codeTom/sensor-design-project/README.md

#### Arduino shield with an optical pulse sensor and amplifier for LM35 temperature sensor

Designed by

Filip Ayazi, Stephen De Bank, Hayley Gilbert
