codeTom/sensor-design-project/fingerholder/README.md

A simple finger-cradle with holes for 5mm LED and photodiode
