codeTom/sensor-design-project/laser_cut_case/README.md

##Case for the arduino and shield based on on OpenCase
Use openscad to build the case. The pre-built dxf is for 3mm material.

For more on OpenCase see https://github.com/joeynovak/open-arduino-case
