codeTom/sensor-design-project/fingerholder/fingertube.stl

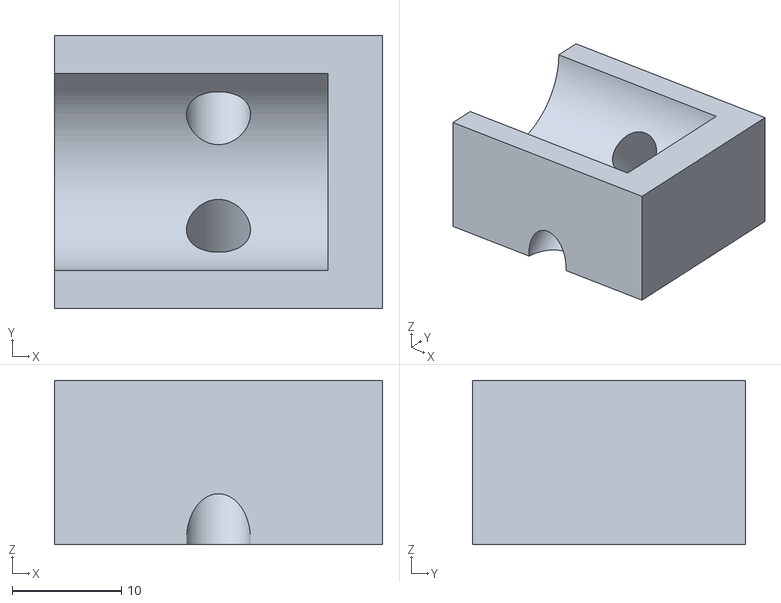
[picture p1: CAD file, 2021-12-16]
fingerholder/fingertube.stl
30.0 x 25.0 x 15.0
