codeTom/sensor-design-project/laser_cut_case/open-case.dxf

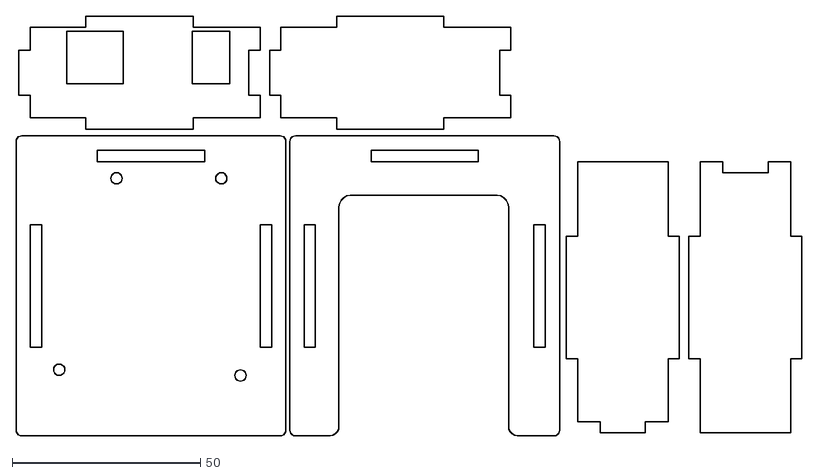
[picture p2: CAD file, 2021-12-16]
laser_cut_case/open-case.dxf
208.6 x 111.4
