codeTom/sensor-design-project/shield_schematics.pdf

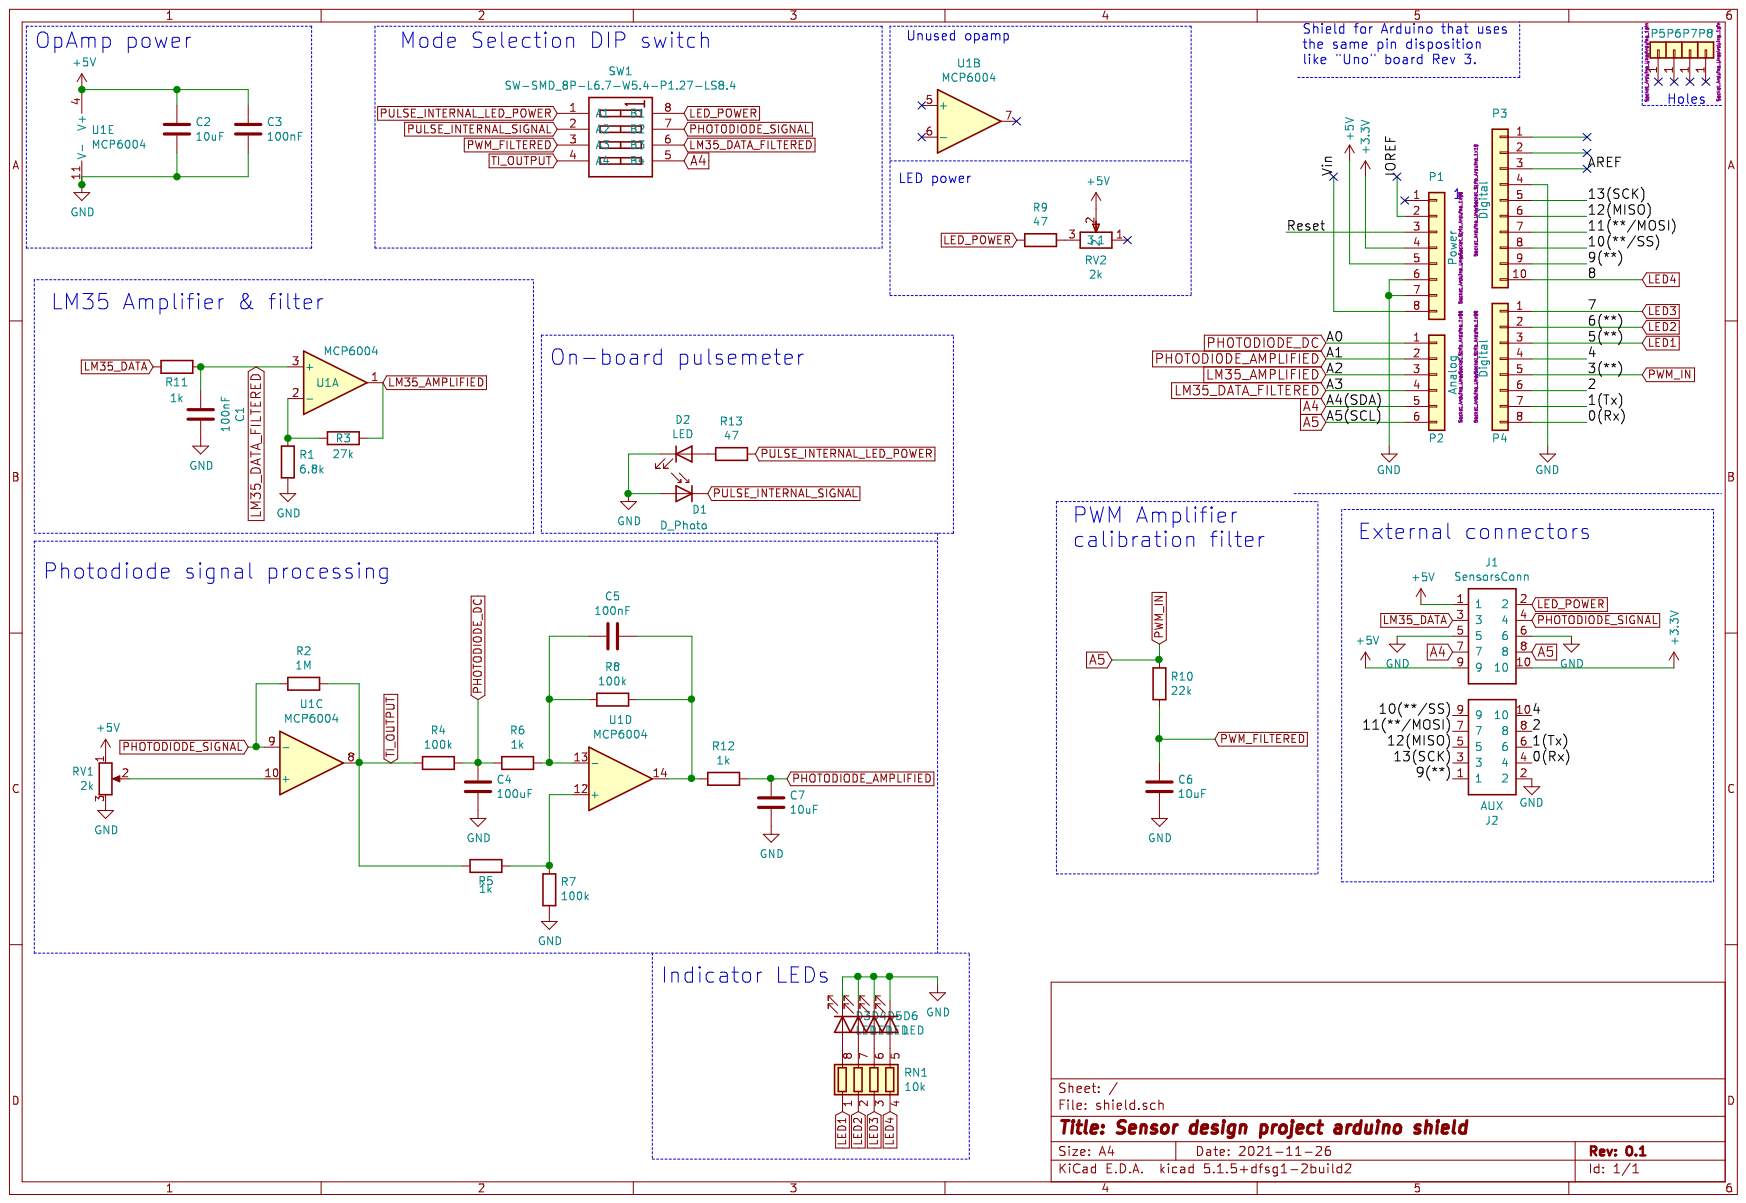
[picture p3: page 1]
