codeTom/sensor-design-project/shield/shield.kicad_pcb

## KiCad design shield/shield.kicad_pcb (2021-12-16)

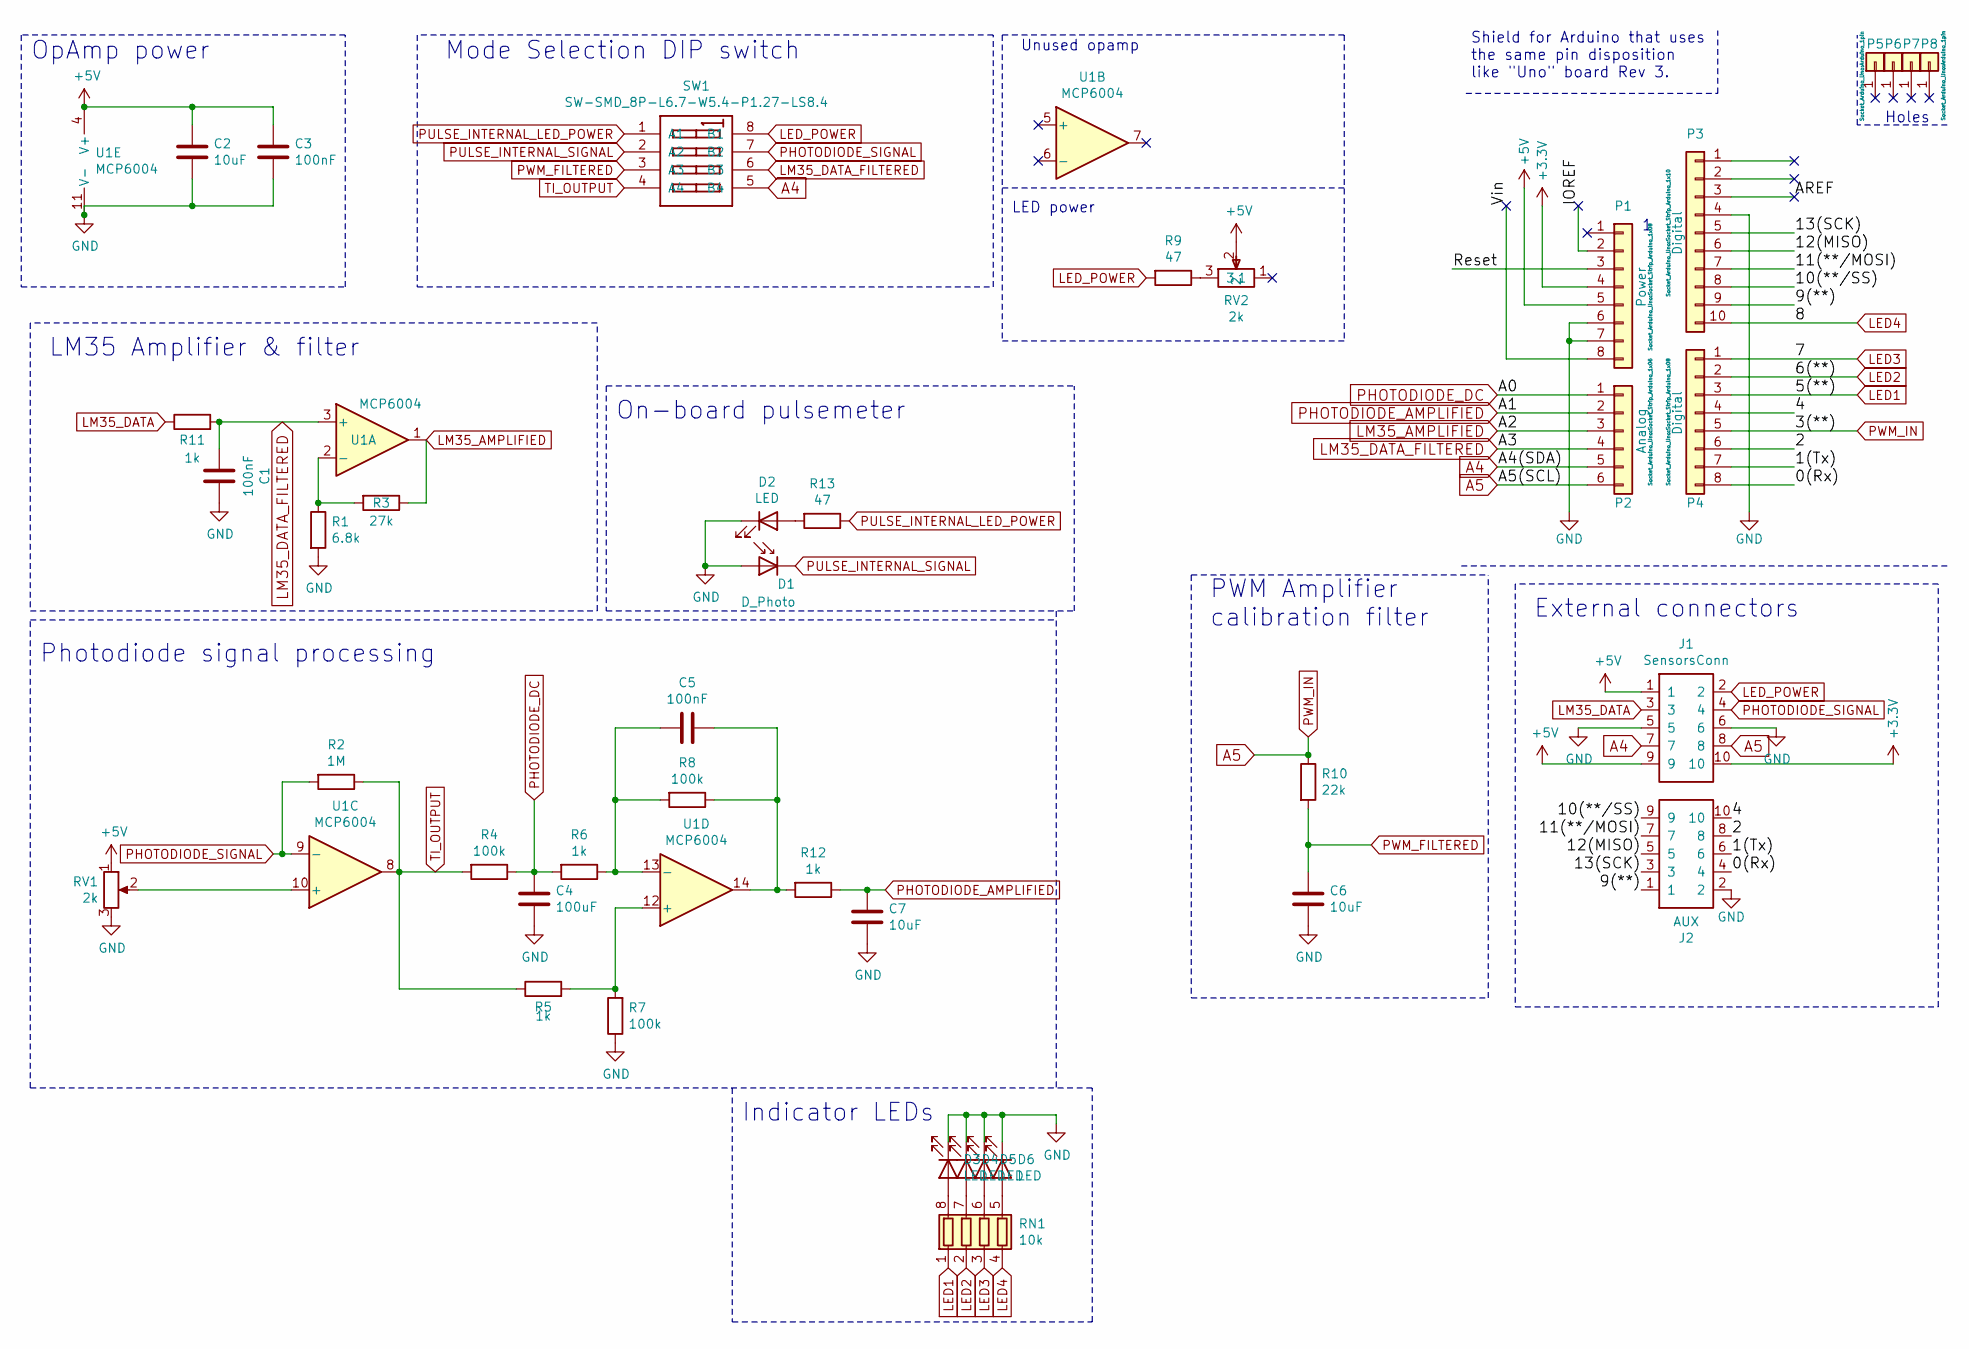
[picture p4: schematic shield.sch, Sensor design project arduino shield]

Parts:
C1, C3, C5: 100nF; C_0402_1005Metric; LCSC C1525
C2, C6, C7: 10uF; C_0402_1005Metric; LCSC C15525
C4: 100uF; C_1206_3216Metric; LCSC C15008
D1: D_Photo; LED_1206_3216Metric; LCSC C16746
D2, D3: LED; LED_0805_2012Metric; LCSC C84256
D4: LED; LED_0805_2012Metric; LCSC C2297
D5: LED; LED_0603_1608Metric; LCSC C72041
D6: LED; LED_0805_2012Metric; LCSC C2296
J1: SensorsConn; CONN-SMD_C843271; LCSC C843271
J2: AUX; CONN-SMD_C843271; LCSC C843271
P1: Power; Socket_Strip_Arduino_1x08
P2: Analog; Socket_Strip_Arduino_1x06
P3: Digital; Socket_Strip_Arduino_1x10
P4: Digital; Socket_Strip_Arduino_1x08
P5, P6, P7, P8: CONN_01X01; Arduino_1pin
R1: 6.8k; R_0603_1608Metric; LCSC C23212
R2: 1M; R_0603_1608Metric; LCSC C22935
R3: 27k; R_0603_1608Metric; LCSC C22967
R4, R7, R8: 100k; R_0603_1608Metric; LCSC C25803
R5, R6, R11, R12: 1k; R_0603_1608Metric; LCSC C21190
R9, R13: 47; R_0805_2012Metric; LCSC C17714
R10: 22k; R_0603_1608Metric; LCSC C31850
RN1: 10k; R_Array_Convex_4x0603; LCSC C29718
RV1, RV2: 2k; RES-ADJ-SMD_G43AT; LCSC C128157
SW1: SW-SMD_8P-L6.7-W5.4-P1.27-LS8.4; LCSC C40736
U1: MCP6004; TSSOP-14_4.4x5mm_P0.65mm; LCSC C50282

Connections:
+3V3: J1.10, P1.4
+5V: C2.1, C3.1, J1.1, J1.9, P1.5, RV1.1, RV2.2, U1.4 (V+)
/0(Rx): J2.4, P4.8
/1(Tx): J2.6, P4.7
/2: J2.8, P4.6
/4: J2.10, P4.4
/9(**): J2.1, P3.9
/10(**/SS): J2.9, P3.8
/11(**/MOSI): J2.7, P3.7
/12(MISO): J2.5, P3.6
/13(SCK): J2.3, P3.5
/AREF: P3.3
/IOREF: P1.2
/Reset: P1.3
/Vin: P1.8
A4: J1.7, P2.5, SW1.5 (B4)
A5: J1.8, P2.6, P4.5, R10.1
GND: C1.1, C2.2, C3.2, C4.2, C6.2, C7.2, D1.2 (A), D2.1 (K), D3.1 (K), D4.1 (K), D5.1 (K), D6.1 (K), J1.5, J1.6, J2.2, P1.6, P1.7, P3.4, R1.2, R7.1, RV1.3, U1.11 (V-)
LED1: P4.3, RN1.1 (R1.1)
LED2: P4.2, RN1.2 (R2.1)
LED3: P4.1, RN1.3 (R3.1)
LED4: P3.10, RN1.4 (R4.1)
LED_POWER: J1.2, R9.2, SW1.8 (B1)
LM35_AMPLIFIED: P2.3, R3.1, U1.1
LM35_DATA: J1.3, R11.1
LM35_DATA_FILTERED: C1.2, P2.4, R11.2, SW1.6 (B3), U1.3 (+)
unnamed: C5.1, R8.1, R12.2, U1.14
unnamed: C5.2, R6.1, R8.2, U1.13 (-)
unnamed: D2.2 (A), R13.2
unnamed: D3.2 (A), RN1.8 (R1.2)
unnamed: D4.2 (A), RN1.7 (R2.2)
unnamed: D5.2 (A), RN1.6 (R3.2)
unnamed: D6.2 (A), RN1.5 (R4.2)
unnamed: R1.1, R3.2, U1.2 (-)
unnamed: R5.2, R7.2, U1.12 (+)
unnamed: R9.1, RV2.3
unnamed: RV1.2, U1.10 (+)
PHOTODIODE_AMPLIFIED: C7.1, P2.2, R12.1
PHOTODIODE_DC: C4.1, P2.1, R4.1, R6.2
PHOTODIODE_SIGNAL: J1.4, R2.2, SW1.7 (B2), U1.9 (-)
PULSE_INTERNAL_LED_POWER: R13.1, SW1.1 (A1)
PULSE_INTERNAL_SIGNAL: D1.1 (K), SW1.2 (A2)
PWM_FILTERED: C6.1, R10.2, SW1.3 (A3)
TI_OUTPUT: R2.1, R4.2, R5.1, SW1.4 (A4), U1.8

Notes on the sheet:
Holes
Shield for Arduino that uses the same pin disposition like "Uno" board Rev 3.
External connectors
PWM Amplifier calibration filter
LM35 Amplifier & filter
OpAmp power
Mode Selection DIP switch
On-board pulsemeter
Unused opamp
Photodiode signal processing
LED power
Indicator LEDs

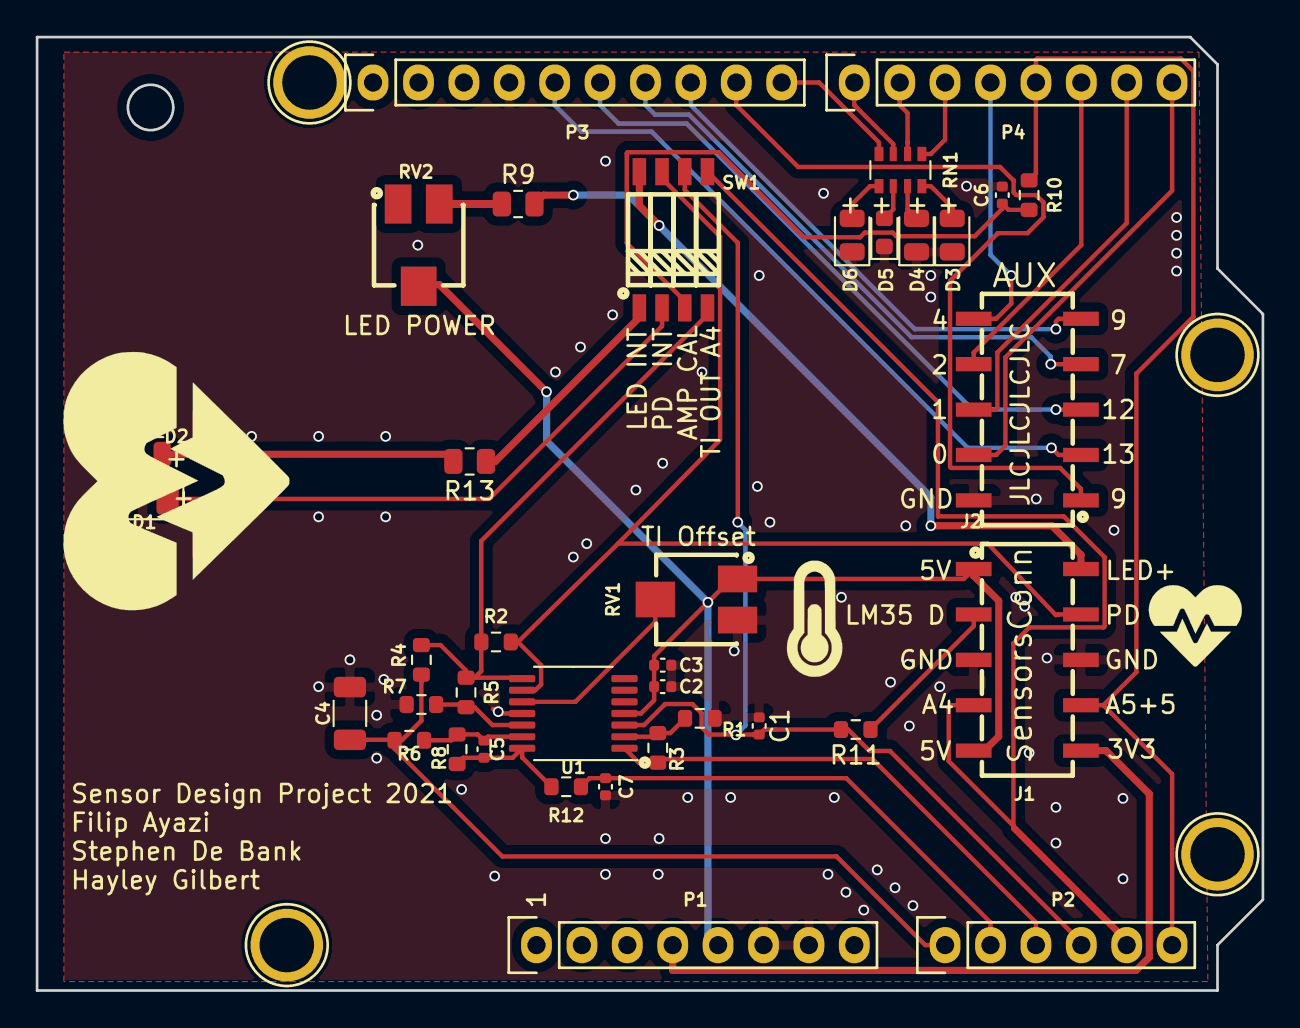
[picture p5: board shield.kicad_pcb from above]

Board: 2 copper layers, 68.6 x 53.3 mm, 41 parts (0 on the bottom side), 40 nets.
